MatevzSedmakS/STM-mikrokrmilnik/ProductionFiles/Assembly/Bill of Materials-STM_mikrokrmilnik.xlsx

Name | Description | Designator | Footprint | LibRef | Quantity | Part Number
100nF | 0.1 µF ±20% 50V Ceramic Capacitor X5R 0402 (1005 Metric) | C1, C2, C4, C5, C7 | CAPACITOR_0402 | 100nF-50V-0402 | 5 | CGA2B3X5R1H104M050BB
4,7uF | 4.7 µF ±10% 25V Ceramic Capacitor X5R 0603 (1608 Metric) | C3, C6, C8 | CAPACITOR_0603 | 4,7uF-25V-0603 | 3 | C1608X5R1E475K080AC
1uF | 1 µF ±10% 25V Ceramic Capacitor X7R 0603 (1608 Metric) | C9, C10 | CAPACITOR_0603 | 1uF-25V-0603 | 2 | CGA3E1X7R1E105K080AC
Male Pins | Connector Header Through Hole 12 position 0.100" (2.54mm) | J1, J2 | SAMTEC_TSW-112-07-L-S | TSW-112-07-L-S | 2 | TSW-112-07-L-S
USB connector | Universal Serial Bus (USB) Shielded I/O Receptacle, Type C, Right-Angle, Top Mount, Surface Mount, 0.80mm Solder Tabs, Gold (Au) Flash over 0.76Âµm Palladium Nickel Plating | J3 | USB_C_CONN_1054500101 | USB_1054500101 | 1 | 1054500101
TSW-102-07-S-S | Connector Header Through Hole 2 position 0.100" (2.54mm) | J4 | SAMTEC_TSW-102-07-L-S | TSW-102-07-S-S | 1 | TSW-102-07-S-S
LED Blue | Blue 470nm LED Indication - Discrete 3.2V 0603 (1608 Metric) | LED1 | LED_0603 | LED-Blue-0603 | 1 | 150060BS75000
10kR | 10 kOhms ±1% 0.063W, 1/16W Chip Resistor 0402 (1005 Metric) Thick Film | R1, R2 | RESISTOR_0402 | 10kR-1%-0402 | 2 | CRCW040210K0FKEDC
5,1kR | 5.1 kOhms ±1% 0.063W, 1/16W Chip Resistor 0402 (1005 Metric) Thick Film | R3, R4 | RESISTOR_0402 | 5,1kR-1%-0402 | 2 | CRCW04025K10FKEDC
510R | 510 Ohms ±1% 0.063W, 1/16W Chip Resistor 0402 (1005 Metric) Automotive AEC-Q200 Thick Film | R5 | RESISTOR_0402 | 510R-1%-0402 | 1 | CRCW0402510RFKED
SWT0310-043016GSA | 6mm x 6mm Gull Wing Tactile Switch | S1 | SWT0310 - switch | SWT0310-043016GSA | 1 | SWT0310-043016GSA
STM32F042K6T6 | Mainstream Arm Cortex-M0 USB line MCU with 32 Kbytes of Flash memory, 48 MHz CPU, USB, CAN and CEC functions | U1 | Quad32-STM32F042K6T6 | STM32F042K6T6 | 1 | STM32F042K6T6
LP5912-3.3DRVR | 500-mA&nbsp;low-noise&nbsp;low-IQ&nbsp;low-dropout voltage regulator with reverse current protect 6-WSON -40 to 125 | U2 | LP5912 | LP5912-3.3DRVR | 1 | LP5912-3.3DRVR
