MatevzSedmakS/STM-mikrokrmilnik/DesignFiles/PCB/STM_mcu_pcb.pdf

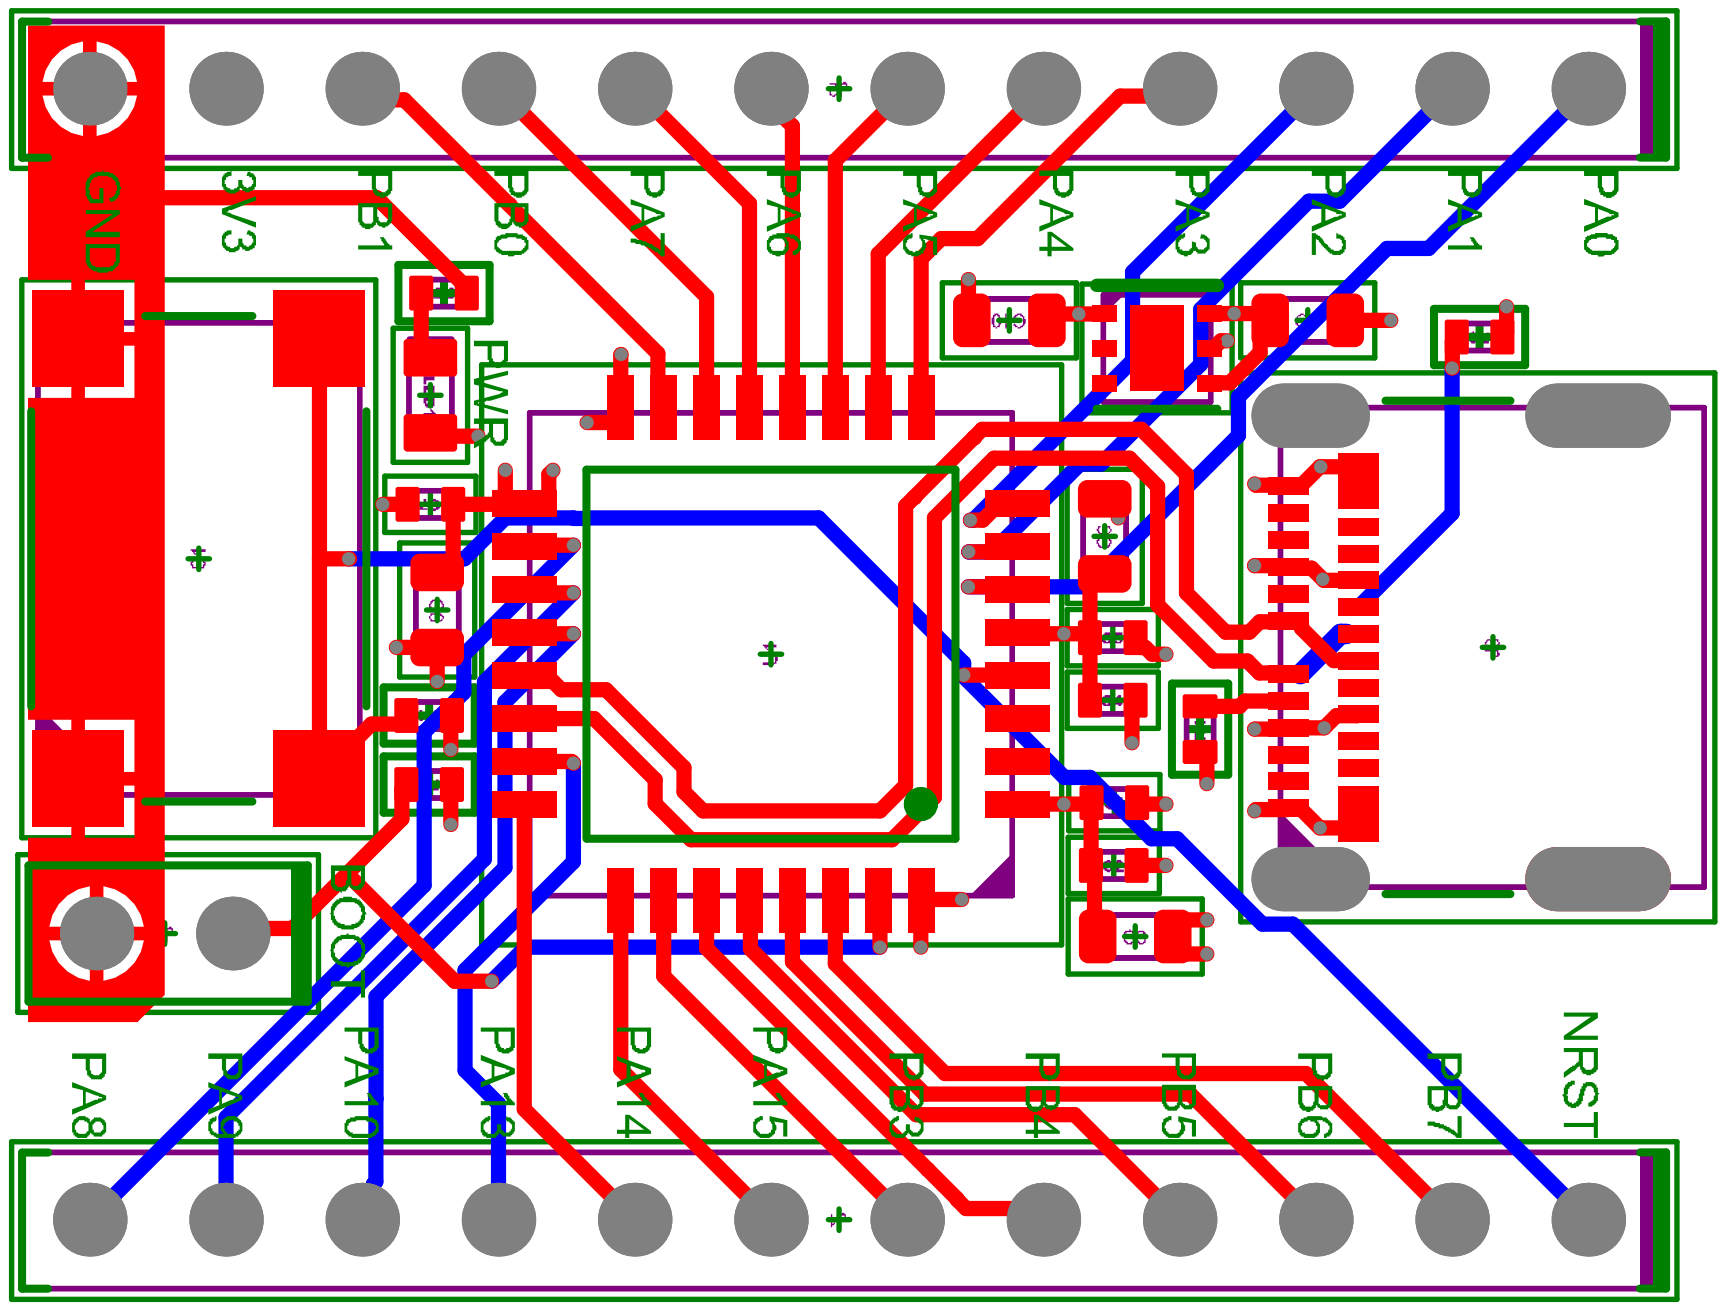
[picture p10: page 1]
