MatevzSedmakS/STM-mikrokrmilnik/ProductionFiles/Assembly/Job1.PDF

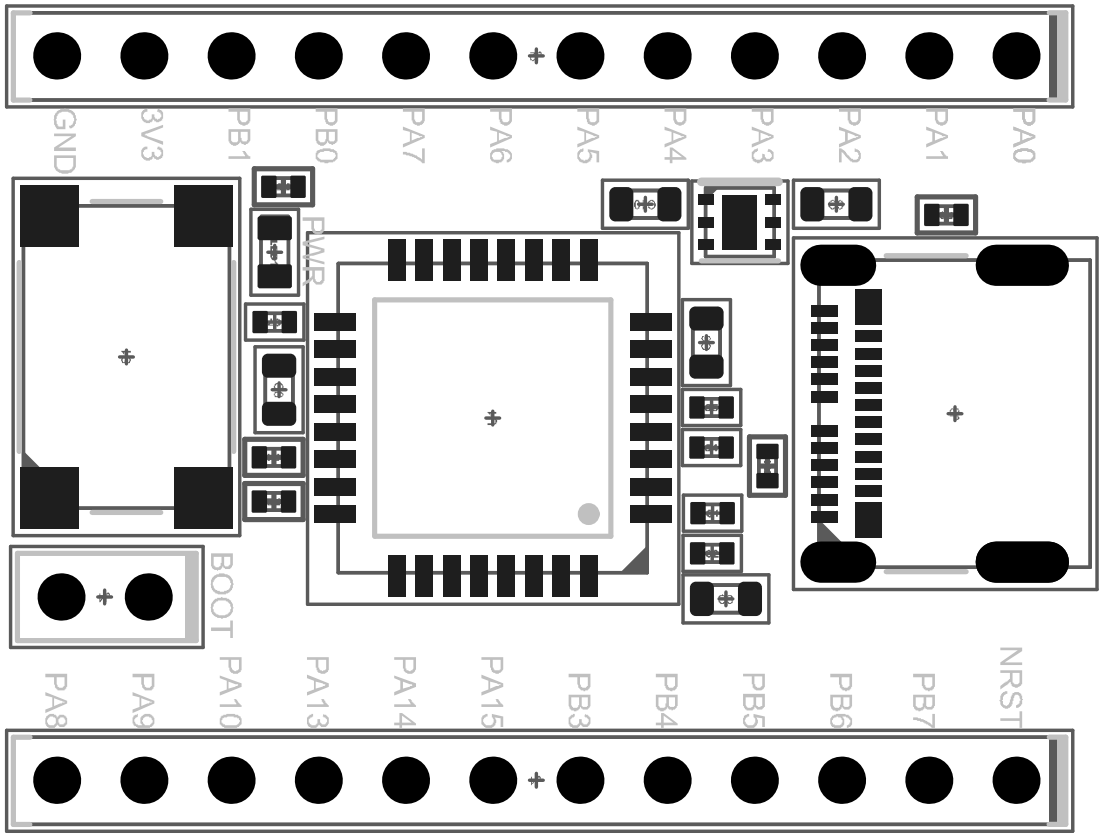
[picture p11: page 1]

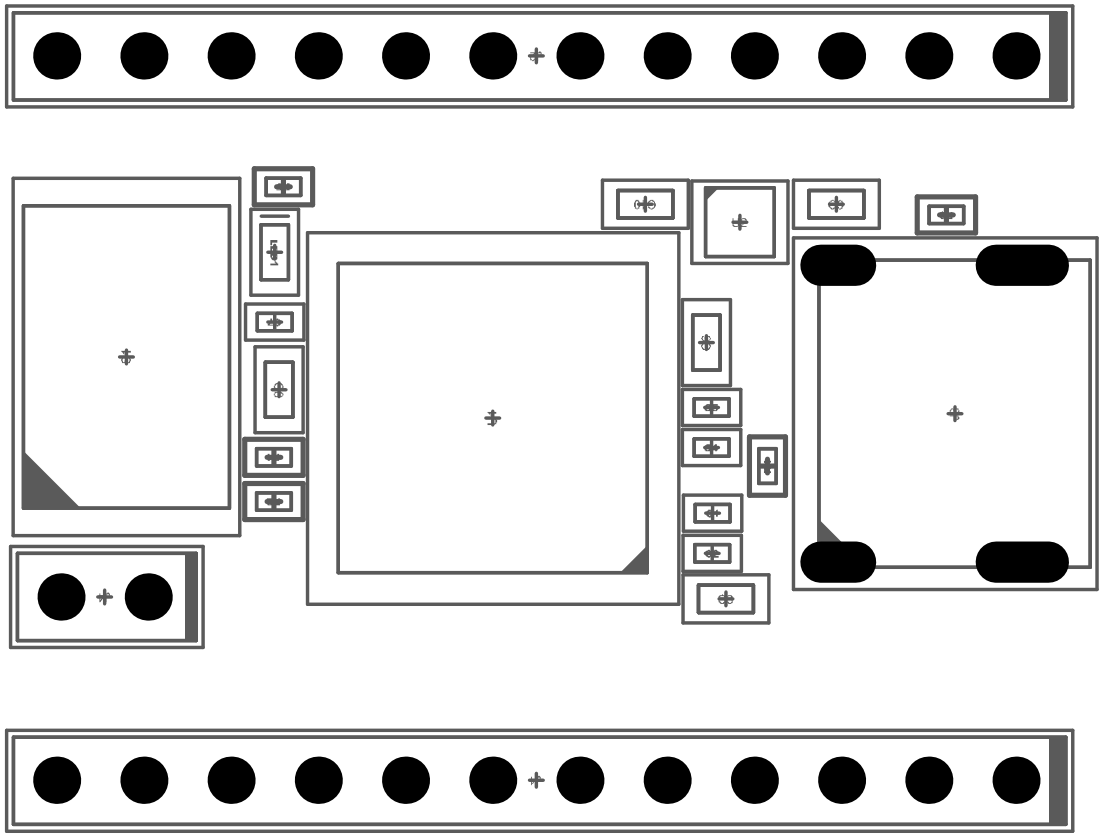
[picture p12: page 2]
