MatevzSedmakS/STM-mikrokrmilnik/STM_mikrokrmilnik.pdf

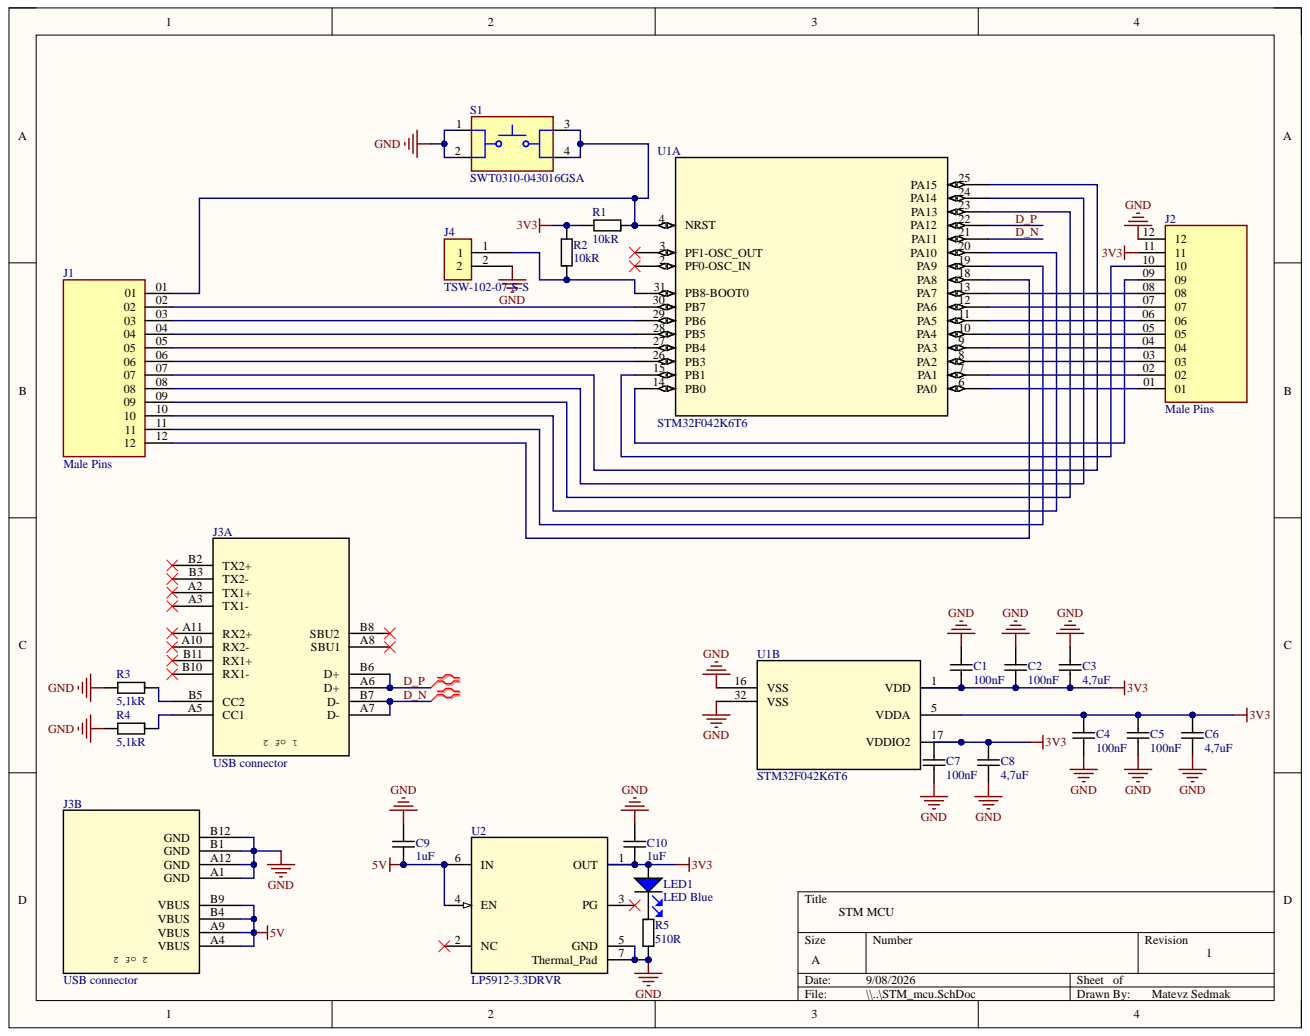
[picture p13: page 1]

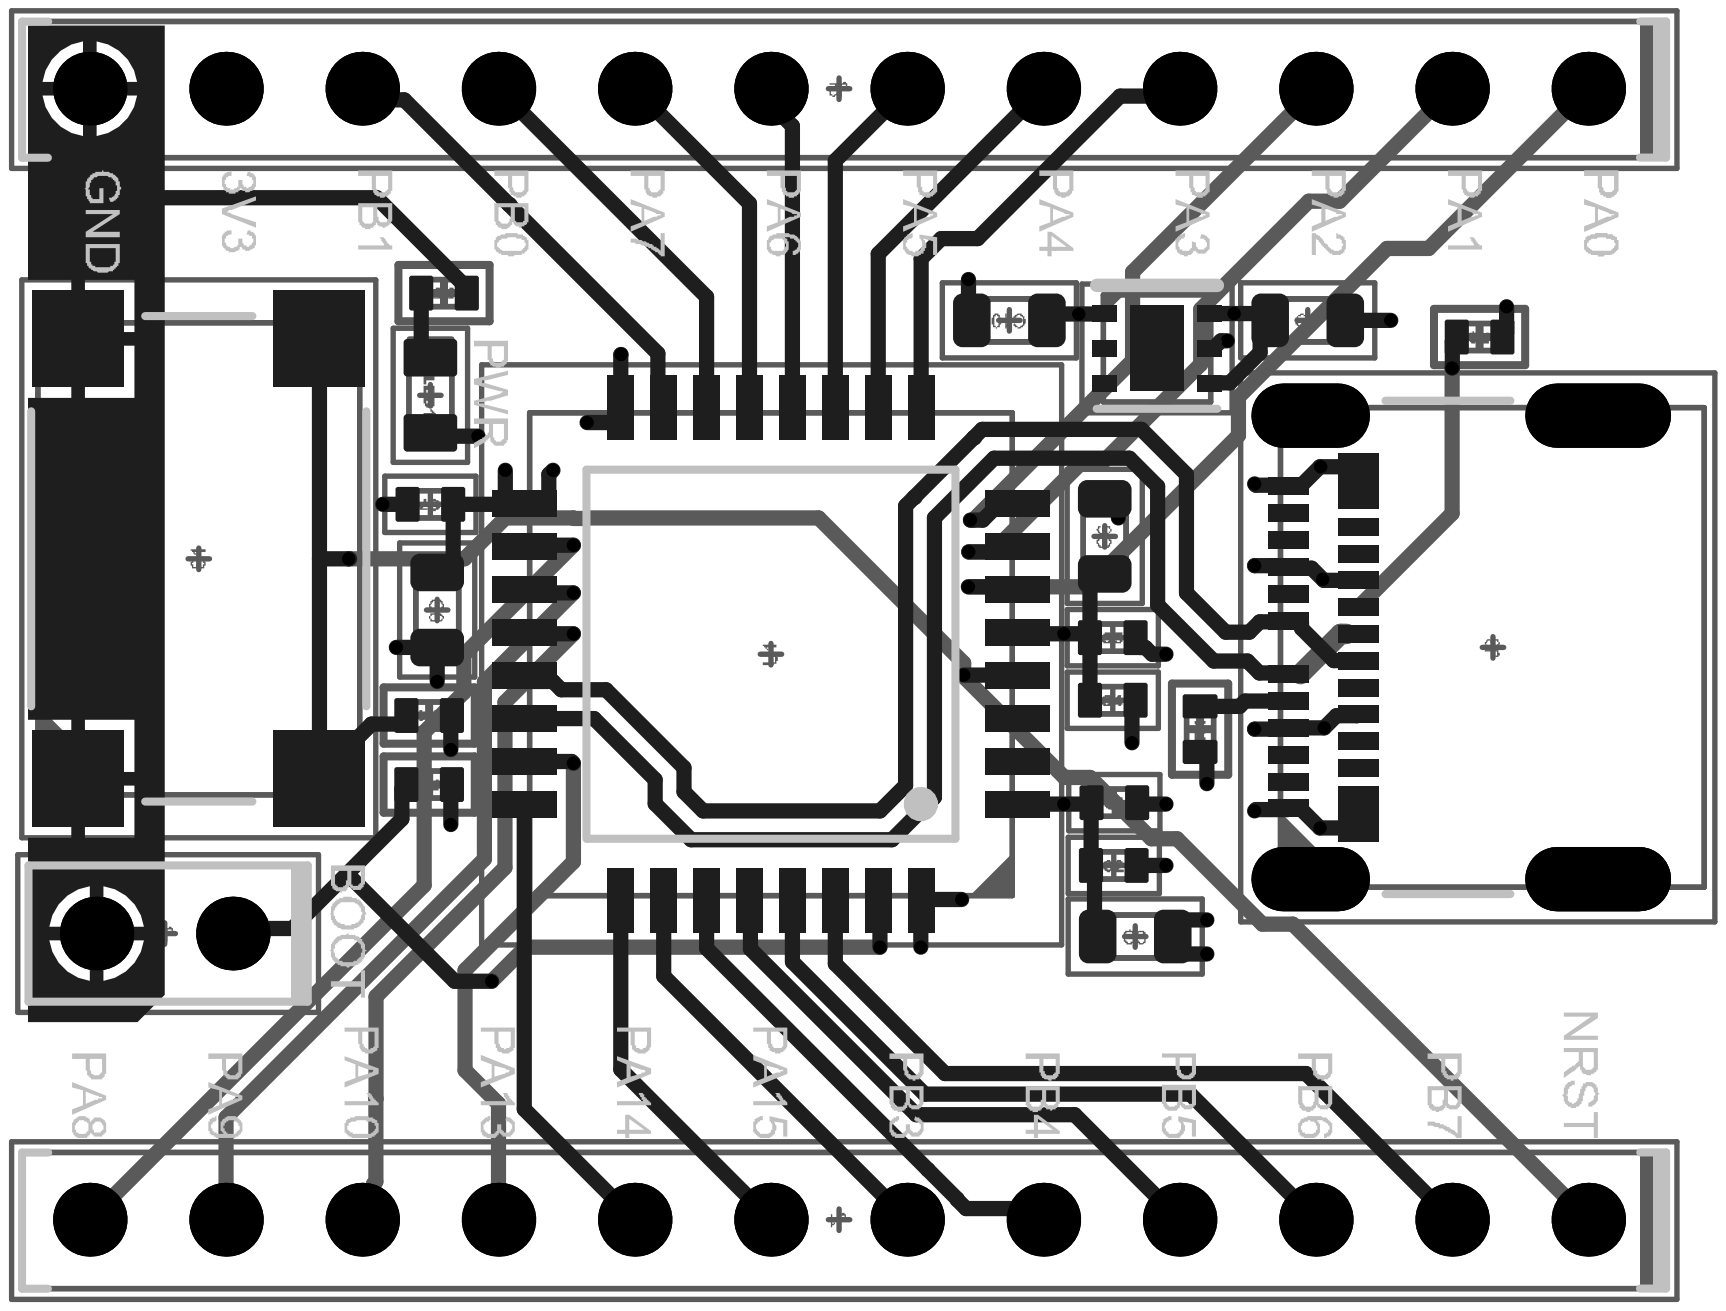
[picture p14: page 2]
