MatevzSedmakS/STM-mikrokrmilnik/(list of files, drawings)

Other design files:
DesignFiles/PCB/STM_mcu.PcbDoc
DesignFiles/SCH/STM_mcu.SchDoc
STM_mikrokrmilnik.PrjPcb
